wwsff/4-switch-buck-boost/代码/STM_POWER_CODE/STM_POWER_CODE/Bench/20261008-ntc-can/使用说明.md

# NTC 温度测量与 H750 温度页（2026-10-08）

固件：G474-BUCK-0.3.51-NTC / H750-NTC-CAN-20261008。需两端一起烧录。

## 对应关系

| 功率板 | 排线脚 | 控制板网络 | G4 引脚 / ADC 常规序列 |
|---|---|---|---|
| R39 MOS NTC | P1.27 | NTC_MOS_USE_1 | PC3 / ADC1_IN9 rank4 |
| R38 电感 NTC | P1.28 | NTC_L_USE_1 | PA2 / ADC1_IN3 rank5 |
| 第二块 MOS NTC | P2.27 | NTC_MOS_USE_2 | PA5 / ADC2_IN13 rank4 |
| 第二块电感 NTC | P2.28 | NTC_L_USE_2 | PA6 / ADC2_IN3 rank5 |

功率板 R33/R34=10k 上拉到 +3.3V_MAIN_GET；R38/R39=HNTC0603-103F3450FA，10k@25℃、B25/85=3450K，下端接 GND。控制板经排线和核心板连接。屏幕板没有本地 NTC，H750 只显示 G4 测量结果。CH2 未装板，保持无效、不在 HMI 显示。

## 实现

G4 使用现有 ADC/DMA 常规 rank4/5，92.5 周期采样。IOC 与生成代码仅补 PA2 的 CH1_TL 名称，无 ADC/PWM/控制时序更改。

温度用 B 参数近似：R/R25=raw/(4095-raw)，1/T=1/298.15+ln(R/R25)/3450；NTC 上拉与 VDDA 共用同一 3.3V 时无需再乘 VDDA 或电压通道校准系数。若实际供电不共源，需要另做供电比校正。

任务内每100ms换算，ADC码 IIR alpha=1/4；第一笔及断线恢复直接初始化，避免从0℃缓慢爬升。近电源轨、模型范围外（约-40..125℃）或陈旧采样立即清有效位，返回-32768，避免显示为正常0℃。原串口遥测的 tmos/tl 与有效位已接入；G4每秒日志包含温度（单位0.01℃）、有效位与原始ADC。H7正常每2秒温度日志，传感器有效状态变化立即日志。

CAN新增可选v1帧0x202，每100ms8字节：MOS int16@0、电感 int16@2，单位0.01℃，通道@4、有效位@5（bit0 MOS/bit1电感）、序号@6、保留0@7。无效值-32768。旧命令、ACK、电压电流遥测、CRC均未改。温度帧不刷新主状态链路的在线时间，也不能改变输出使能状态。

H7点击顶部左侧 POWER> 打开温度页；点击顶部 TEMP 或 BACK 返回。显示MOS/电感温度到0.1℃，支持负值；异常显示--.-C和红色SENSOR ERR，尚未收到显示WAIT DATA，超过1秒没有温度帧显示STALE，无设备显示NO DEVICE和--.-C。温度页只读，编码器/K1/K2不修改隐藏设定；STOP/START、CLR仍按控制板状态工作。主页面编码器/K1/K2交互保持。两页保留5×5红点，5秒后只恢复25像素；只有切换页面才全屏重画。

## 验证与限制

七组专项检查402项通过：NTC26、CAN编码68、G4校零47、G4命令26、H7协议69、H7 UI106、跨工程协议60。IOC/生成代码、H7 Keil清单、H7意图检查通过。两端Keil ARMCC5构建0 errors/0 warnings，日志及HEX/AXF同目录。

G4 Code63512 RO2796 RW580 ZI43244；H7 Code48536 RO3232 RW280 ZI24728。

本轮未烧录或做真实温度标定。B模型是测温近似，显示值是NTC位置温度，不是MOS结温；数字分辨率不代表测量精度。PD_NTC_VERIFIED仍为0，本版只测量/提示，不启用新增过温停机。原IOUT启动校零、CAN控制权、输出保护保留。原台架限制（无CH2、无电感快过流等）未改变，不是量产固件。历史G4完整88项中的16项失败未在本次处理，不能把专项通过当作全部回归通过。

## 上板检查

1. 两端烧录本目录HEX，查看启动日志版本；先保持输出关闭。
2. 常温两路温度应接近实际板温；用温度计比对，约25℃时ADC接近2048。
3. 分别轻微加热NTC附近，两路数值应分别上升（MOS与电感对应不得互换）。
4. 断电后模拟NTC开路/短路，再上电保持输出关闭，应显示SENSOR ERR；恢复后应正常。不要带电插拔功率排线。
5. 检查离线/重连、温度页STOP/返回及红点5秒局部恢复；再按已验证条件做5V输出、停止与再次启动。
