wwsff/4-switch-buck-boost/COPYRIGHT.md

# 授权范围与版权说明

Copyright (c) 2026 SZPUW

- SZPUW拥有授权权利的原创G474应用固件、H750应用固件、PowerDesk代码和项目说明：GPL-3.0-only。完整正文见LICENSE。
- SZPUW拥有授权权利的原创硬件.epro2工程：MIT。完整正文见LICENSE_HARDWARE_MIT.txt。
- 第三方代码和资源保留原版权及许可证，不能由本说明统一改为GPL或MIT。具体材料见THIRD_PARTY_NOTICES.md及各源码目录。
- GPL允许个人修改使用与商业分发；分发受GPL约束的修改版、HEX或含该固件的成品时，应按GPL提供对应源码及必要构建材料。
- 本项目是实验开发版本，实测工作点与未验收内容见README_开源使用说明.md，许可证不构成电源性能认证或硬件安全证书。

GPL正文取自SPDX维护的标准文本：https://raw.githubusercontent.com/spdx/license-list-data/main/text/GPL-3.0-only.txt
MIT正文采用标准MIT许可文本，仅填入作者与年份。GPL标准正文中的Free Software Foundation版权属于许可证文本本身，不是本项目作者署名。
