wwsff/4-switch-buck-boost/压缩包清理说明.md

# 发布压缩包清理说明

日期：2026-10-09。作者：SZPUW。

本次只清理分发包与补许可证，不改变固件功能，不重新编译或烧录。

| 软件包 | 原大小（MiB） | 新大小（MiB） | 保留文件 | 移除文件 |
|---|---:|---:|---:|---:|
| PowerDesk.zip | 0.70 | 0.08 | 30 | 225 |
| STM_POWER_CODE.zip | 172.83 | 8.81 | 1280 | 3795 |
| STM_POWER_LCD.zip | 98.19 | 12.32 | 1735 | 2208 |

## 保留内容

应用/外设/启动源码、IOC、Keil工程与链接脚本、工程需要的驱动和中间件、原第三方许可证、协议、测试源码、必要检查工具、Bench/20261008-ntc-can中的HEX/AXF/构建记录/哈希与使用说明。

## 移除内容

.git等版本历史、__pycache__、作者profiles.json、服务日志、Keil对象/调试状态/旧镜像、tests/build及HostTest/build输出、历史Release、旧Bench、未被工程链接使用的SDK预编译库/网页文档、一次性分析/迁移/旧发布脚本和过时综合验证文档。源码中的历史注释与实际功能不重写。

## 校验

新ZIP逐项读回并校验CRC与SHA256；所有Keil FilePath与IncludePath均存在；保留的源码、头文件、测试脚本、IOC和工程配置逐字节与原ZIP相同；原第三方LICENSE逐字节保留。配套Bench没有重新编译，原SHA256SUMS继续对应保留文件。没有执行目标构建或硬件测试，清理不代表性能/故障验收通过。

## 许可证

原创软件/配套文档GPL-3.0-only，原创硬件MIT，署名Copyright (c) 2026 SZPUW。根目录与三个ZIP附完整GPL正文和版权范围说明；第三方版权不覆盖。商家字体只有来源记录，没有明确再分发条款，作者认为可使用，但许可仍待核实，见THIRD_PARTY_NOTICES.md。

## 工具与历史证据边界

宿主C测试脚本仍保留开发机GCC路径，换电脑需核对；不把旧DLL/EXE打入包来掩盖这一要求。根层跨工程工具不在这三个软件包内，README只列已随包工具。专项测试历史402项和完整套件遗留失败并未因为清理改变。

## 原包备份

原ZIP和旧发布README已由作者工作区留存备份，未放入开源目录，避免把清除内容再次公开。清理明细/原新哈希在作者工作区归档，公开下载文件以SHA256SUMS为准。
