wwsff/4-switch-buck-boost/代码/STM_POWER_LCD/STM_POWER_LCD/Bench/20261008-ntc-can/temperature_live.png

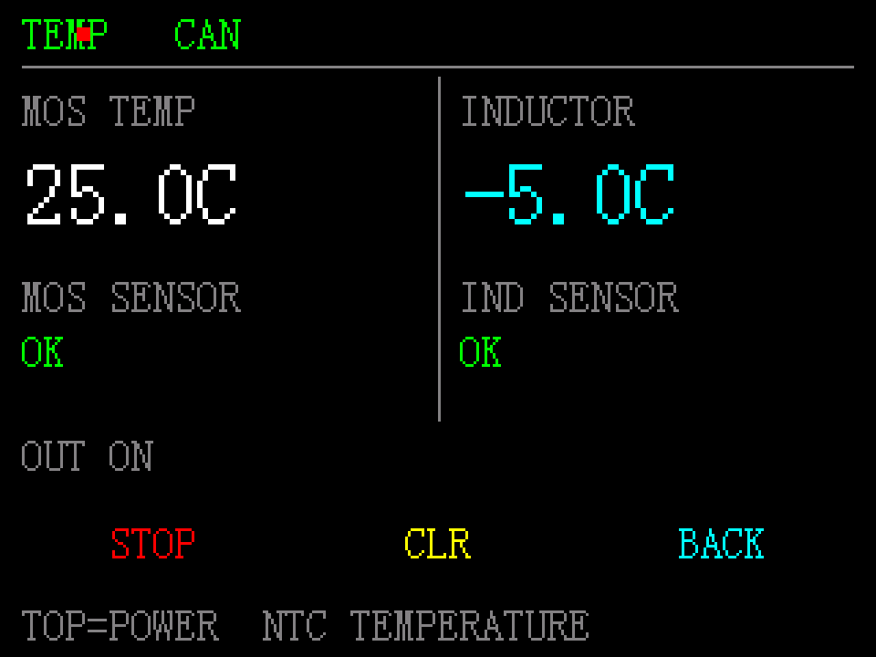
代码/STM_POWER_LCD/STM_POWER_LCD/Bench/20261008-ntc-can/temperature_live.png
