wwsff/4-switch-buck-boost/代码/STM_POWER_CODE/STM_POWER_CODE/Bench/20261008-ntc-can/build_final.txt

*** Using Compiler 'V5.05 update 1 (build 106)', folder: 'D:\keil5\ARM\ARMCC\Bin'
Build target 'STM_POWER_CODE'
compiling pd_board.c...
linking...
Program Size: Code=63512 RO-data=2796 RW-data=580 ZI-data=43244  
FromELF: creating hex file...
"ReviewBuild\STM_POWER_CODE.axf" - 0 Error(s), 0 Warning(s).
Build Time Elapsed:  00:00:03
