wwsff/4-switch-buck-boost/代码/STM_POWER_CODE/STM_POWER_CODE/Bench/20261008-ntc-can/build_full.txt

*** Using Compiler 'V5.05 update 1 (build 106)', folder: 'D:\keil5\ARM\ARMCC\Bin'
Rebuild target 'STM_POWER_CODE'
compiling pd_zero.c...
compiling pd_retarget.c...
compiling pd_core.c...
assembling startup_stm32g474xx.s...
compiling pd_modulation.c...
compiling pd_diag.c...
compiling stm32g4xx_ll_adc.c...
compiling pd_pid.c...
compiling pd_cmp.c...
compiling pd_can.c...
compiling pd_oc.c...
compiling pd_power.c...
compiling adc.c...
compiling stm32g4xx_hal_cortex.c...
compiling stm32g4xx_hal_tim_ex.c...
compiling stm32g4xx_hal_flash_ex.c...
compiling stm32g4xx_hal_dma_ex.c...
compiling stm32g4xx_hal_exti.c...
compiling stm32g4xx_hal_adc.c...
compiling croutine.c...
compiling tim.c...
compiling stm32g4xx_hal_rcc_ex.c...
compiling stm32g4xx_hal_dma.c...
compiling stm32g4xx_hal_msp.c...
compiling event_groups.c...
compiling main.c...
compiling list.c...
compiling hrtim.c...
compiling stream_buffer.c...
compiling queue.c...
compiling timers.c...
compiling heap_4.c...
compiling tasks.c...
compiling port.c...
compiling stm32g4xx_hal_flash.c...
compiling stm32g4xx_hal_timebase_tim.c...
compiling stm32g4xx_it.c...
compiling pd_can_port.c...
compiling stm32g4xx_hal_tim.c...
compiling app_freertos.c...
compiling stm32g4xx_hal_adc_ex.c...
compiling usart.c...
compiling dma.c...
compiling gpio.c...
compiling stm32g4xx_hal_rcc.c...
compiling stm32g4xx_hal_pwr_ex.c...
compiling fdcan.c...
compiling stm32g4xx_hal_pwr.c...
compiling stm32g4xx_hal.c...
compiling stm32g4xx_hal_flash_ramfunc.c...
compiling stm32g4xx_hal_fdcan.c...
compiling stm32g4xx_hal_gpio.c...
compiling pd_board.c...
compiling stm32g4xx_hal_uart_ex.c...
compiling system_stm32g4xx.c...
compiling stm32g4xx_hal_uart.c...
compiling cmsis_os2.c...
compiling stm32g4xx_hal_hrtim.c...
linking...
Program Size: Code=63512 RO-data=2796 RW-data=580 ZI-data=43244  
FromELF: creating hex file...
"ReviewBuild\STM_POWER_CODE.axf" - 0 Error(s), 0 Warning(s).
Build Time Elapsed:  00:00:12
