wwsff/4-switch-buck-boost/代码/STM_POWER_LCD/STM_POWER_LCD/Bench/20261008-ntc-can/build_final.txt

*** Using Compiler 'V5.05 update 1 (build 106)', folder: 'D:\keil5\ARM\ARMCC\Bin'
Build target 'STM_POWER_LCD'
compiling ui_main.c...
linking...
Program Size: Code=48536 RO-data=3232 RW-data=280 ZI-data=24728  
FromELF: creating hex file...
"ReviewBuild\STM_POWER_LCD.axf" - 0 Error(s), 0 Warning(s).
Build Time Elapsed:  00:00:05
