wwsff/4-switch-buck-boost/代码/STM_POWER_LCD/STM_POWER_LCD/Bench/20261008-ntc-can/build_full.txt

*** Using Compiler 'V5.05 update 1 (build 106)', folder: 'D:\keil5\ARM\ARMCC\Bin'
Rebuild target 'STM_POWER_LCD'
assembling startup_stm32h750xx.s...
compiling stm32h7xx_hal_fdcan.c...
compiling stm32h7xx_hal_pwr.c...
compiling i2c.c...
compiling tim.c...
compiling mpu_wrappers_v2.c...
compiling stm32h7xx_hal_hsem.c...
compiling croutine.c...
compiling stm32h7xx_hal_spi_ex.c...
compiling event_groups.c...
compiling list.c...
compiling queue.c...
compiling stream_buffer.c...
compiling timers.c...
compiling tasks.c...
compiling stm32h7xx_hal_i2c_ex.c...
compiling heap_4.c...
compiling stm32h7xx_hal_exti.c...
compiling port.c...
compiling stm32h7xx_hal_pwr_ex.c...
compiling app_input.c...
compiling usart.c...
compiling stm32h7xx_hal_dma_ex.c...
compiling stm32h7xx_hal_msp.c...
compiling stm32h7xx_hal_flash_ex.c...
compiling stm32h7xx_hal_timebase_tim.c...
compiling ui_model.c...
compiling fdcan.c...
compiling stm32h7xx_hal_flash.c...
compiling stm32h7xx_hal_cortex.c...
compiling main.c...
compiling stm32h7xx_it.c...
compiling stm32h7xx_hal_tim_ex.c...
compiling stm32h7xx_hal_gpio.c...
compiling stm32h7xx_hal_i2c.c...
compiling spi.c...
compiling stm32h7xx_hal_tim.c...
compiling stm32h7xx_hal_rcc.c...
compiling stm32h7xx_hal_uart_ex.c...
compiling stm32h7xx_hal_mdma.c...
compiling stm32h7xx_hal.c...
compiling gpio.c...
compiling freertos.c...
compiling stm32h7xx_hal_spi.c...
compiling touch.c...
compiling app_bringup.c...
compiling system_stm32h7xx.c...
compiling can_if.c...
compiling cmsis_os2.c...
compiling lcd.c...
compiling can_proto.c...
compiling gfx_text.c...
compiling ui_main.c...
compiling bsp_log.c...
compiling stm32h7xx_hal_uart.c...
compiling stm32h7xx_hal_rcc_ex.c...
compiling stm32h7xx_hal_dma.c...
linking...
Program Size: Code=48328 RO-data=3232 RW-data=276 ZI-data=24724  
FromELF: creating hex file...
"ReviewBuild\STM_POWER_LCD.axf" - 0 Error(s), 0 Warning(s).
Build Time Elapsed:  00:00:25
