wwsff/4-switch-buck-boost/代码/STM_POWER_CODE/STM_POWER_CODE/Core/Src/app_freertos.c

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

/* Includes ------------------------------------------------------------------*/
#include "FreeRTOS.h"
#include "task.h"
#include "main.h"
#include "cmsis_os.h"
#include "pd_can_port.h"
#include "pd_core.h"

/* USER CODE BEGIN Includes */
#include "pd_board.h"
/* USER CODE END Includes */

/* Definitions for defaultTask */
osThreadId_t defaultTaskHandle;
const osThreadAttr_t defaultTask_attributes = {
  .name = "defaultTask",
  .priority = (osPriority_t) osPriorityNormal,
  .stack_size = 1024 * 4
};

void StartDefaultTask(void *argument);

void MX_FREERTOS_Init(void); /* (MISRA C 2004 rule 8.1) */

/* Hook prototypes */
void vApplicationStackOverflowHook(xTaskHandle xTask, signed char *pcTaskName);
void vApplicationMallocFailedHook(void);

/* USER CODE BEGIN 4 */
void vApplicationStackOverflowHook(xTaskHandle xTask, signed char *pcTaskName)
{
  (void)xTask; (void)pcTaskName; PD_BoardEmergencyStop(); __disable_irq(); for (;;) {}
}
/* USER CODE END 4 */

/* USER CODE BEGIN 5 */
void vApplicationMallocFailedHook(void)
{
  PD_BoardEmergencyStop(); __disable_irq(); for (;;) {}
}
/* USER CODE END 5 */

/**
  * @brief  FreeRTOS initialization
  * @param  None
  * @retval None
  */
void MX_FREERTOS_Init(void) {
  /* USER CODE BEGIN RTOS_MUTEX */
  /* add mutexes, ... */
  /* USER CODE END RTOS_MUTEX */

  /* USER CODE BEGIN RTOS_SEMAPHORES */
  /* add semaphores, ... */
  /* USER CODE END RTOS_SEMAPHORES */

  /* USER CODE BEGIN RTOS_TIMERS */
  /* start timers, add new ones, ... */
  /* USER CODE END RTOS_TIMERS */

  /* USER CODE BEGIN RTOS_QUEUES */
  /* add queues, ... */
  /* USER CODE END RTOS_QUEUES */

  /* Create the thread(s) */
  /* creation of defaultTask */
  defaultTaskHandle = osThreadNew(StartDefaultTask, NULL, &defaultTask_attributes);

  /* USER CODE BEGIN RTOS_THREADS */
  if (defaultTaskHandle == NULL) { Error_Handler(); }
  /* USER CODE END RTOS_THREADS */

  /* USER CODE BEGIN RTOS_EVENTS */
  /* add events, ... */
  /* USER CODE END RTOS_EVENTS */

}

/* USER CODE BEGIN Header_StartDefaultTask */
/**
  * @brief  Function implementing the defaultTask thread.
  * @param  argument: Not used
  * @retval None
  */
/* USER CODE END Header_StartDefaultTask */
void StartDefaultTask(void *argument)
{
  /* USER CODE BEGIN StartDefaultTask */
  (void)argument;
  /* Bring up the CAN endpoint before the loop so a HMI that is already
     talking gets its capability frames as soon as the bus is up. */
  if (PD_CanPortInit() != 0)
  {
    PD_Log(0, 2, 21, "CAN init failed; serial control only");
  }
  else
  {
    PD_CanPortAnnounce();
  }
  for (;;) { PD_BoardPoll(); PD_CanPortPoll(); osDelay(1); }
  /* USER CODE END StartDefaultTask */
}
