wwsff/4-switch-buck-boost/代码/PowerDesk/tests/test_device.py

import tempfile
import time
import unittest
from pathlib import Path
from unittest.mock import patch

import profiles
from device import Device, DeviceError
from protocol import CMD, SCHEMA_CRC, Frame, KIND, pack, unpack
from simulator import DemoSerial


class DeviceTests(unittest.TestCase):
    def setUp(self):
        self.tmp = tempfile.TemporaryDirectory()
        self.profile_patch = patch.object(profiles, "PATH", Path(self.tmp.name) / "profiles.json")
        self.profile_patch.start()
        self.d = Device()
        self.d.connect("", demo=True, auto_restore=False)

    def tearDown(self):
        self.d.disconnect()
        self.profile_patch.stop()
        self.tmp.cleanup()

    def refresh(self):
        time.sleep(0.07)
        return self.d.snapshot()

    def test_handshake_capabilities_and_default_off(self):
        self.assertTrue(self.d.connected)
        self.assertEqual(self.d.info["schema_crc"], SCHEMA_CRC)
        self.assertEqual(set(self.d.caps), {1, 2})
        self.assertTrue(all(t["enabled"] == 0 for t in self.d.telemetry.values()))

    def test_host_range_comes_from_caps_not_from_a_host_constant(self):
        """0.3.22 widened CH1 from 2..15 V to 2..18 V. The host must follow the
        CAPS the device reports in both cases: an old firmware must still show
        2..15 V, a new one 2..18 V, and the range must never be a host constant."""
        self.assertEqual((self.d.caps[1]["vmin_mv"], self.d.caps[1]["vmax_mv"]), (2000, 18000))
        self.assertEqual(self.d.action("target", 1, {"vref_mv": 18000, "iref_ma": 1000})["vref_mv"], 18000)
        with self.assertRaisesRegex(DeviceError, "范围"):
            self.d.action("target", 1, {"vref_mv": 18001, "iref_ma": 1000})
        old = dict(self.d.caps[1])
        self.d.caps[1]["vmax_mv"] = 15000                    # simulate an old firmware
        with self.assertRaisesRegex(DeviceError, "范围"):
            self.d.action("target", 1, {"vref_mv": 18000, "iref_ma": 1000})
        self.assertEqual(self.d.action("target", 1, {"vref_mv": 15000, "iref_ma": 1000})["vref_mv"], 15000)
        self.d.caps[1].update(old)

    def test_zero_not_exposed_by_unsupported_demo(self):
        with self.assertRaisesRegex(DeviceError,'未开放'):
            self.d.action('zero',1,{'action':1})

    def test_zero_ack_is_pending_and_query_is_read_only(self):
        self.d.caps[1]['features'] |= 64
        pending=dict(state=1,sensor=1,applied=0,reason=0,samples=0,reserved=0,
                     iout_uv=1650000,il_uv=1650000,pp_uv=0,span_uv=0)
        with patch.object(self.d,'request',return_value=pending) as req:
            self.assertEqual(self.d.action('zero',1,{'action':1})['state'],1)
            req.assert_called_once_with('ZERO',1,'zero_request',{'action':1},'zero_status')
            req.reset_mock()
            self.d.action('zero',1,{'action':0})
            req.assert_called_once_with('ZERO',1,'zero_request',{'action':0},'zero_status')
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
