wwsff/4-switch-buck-boost/(notices)

Notices in the files:
代码/STM_POWER_CODE/STM_POWER_CODE/Core/Src/adc.c:
Copyright (c) 2026 STMicroelectronics.
All rights reserved.
This software is licensed under terms that can be found in the LICENSE file
